NicolasPlata2004/ADANISS-2R/Videos_Youtube/02_Episodios/EP01/youtube/publicacion.md

# EP01 · Publicación en YouTube

## Título (elige uno, menos de 60 caracteres)

1. **¿Qué hay dentro de un cargador de celular?** (recomendado, va con la miniatura "¿QUÉ HAY DENTRO?")
2. Cómo 230 V se vuelven 5 V sin quemar tu celular
3. Tu cargador NO es solo un cable (y eso te protege)

## Miniatura

`final/EP01_miniatura.png` (1280×720). Mismo estilo Pizarra del video: "¿QUÉ HAY / DENTRO?", el cargador al centro, la marea roja que entra y la línea azul que sale.

## Descripción (copiar y pegar)

```
Son las 7:30, tu celular marca 4% y lo conectas sin pensar. Pero lo que sale del enchufe cambia de sentido unas 100 veces por segundo y empuja decenas de veces más fuerte de lo que tu batería aguanta. Entre los dos solo hay una cajita que cabe en tu mano. Seguimos la energía desde el enchufe hasta la batería: diodos, puente rectificador, condensador, conmutación, flyback, aislamiento galvánico, optoacoplador y USB Power Delivery.

00:00 Intro: 4% de batería
00:45 La analogía del agua
01:25 1. El sentido: diodos y puente rectificador
02:39 2. La presión: conmutación y flyback
04:31 3. El control: regulación y optoacoplador
05:07 4. Potencia y USB Power Delivery
05:59 5. El teléfono manda
06:18 Resumen

Glosario rápido
· Diodo: deja pasar la corriente en un solo sentido.
· Puente rectificador: 4 diodos que convierten la alterna en "colinas" de un solo sentido.
· Condensador de filtrado: se carga en las cimas y suelta energía en los valles.
· Flyback: guarda energía en el campo magnético del transformador y la suelta al otro lado.
· Aislamiento galvánico: entrada y salida sin conexión eléctrica directa.
· Optoacoplador: lleva la información de la salida a la entrada con luz.
· USB Power Delivery: el cargador ofrece un menú de tensiones (5, 9, 15, 20 V) y el teléfono elige.

#electronica #mecatronica #ingenieria
```

## Etiquetas

cargador de celular, cómo funciona un cargador, fuente conmutada, flyback, puente rectificador, diodo, condensador, corriente alterna, corriente continua, USB Power Delivery, carga rápida, aislamiento galvánico, optoacoplador, electrónica, mecatrónica, ingeniería

## Subtítulos

Sube `youtube/subtitulos.srt` en *Subtítulos > Español* (ya vienen corregidos: "alisarlo", "eléctrica", "4%", "USB-C").

## Pantalla final y tarjetas

- Los últimos 10 s del video (6:48–6:58) son la pantalla final: a la izquierda va el botón **Suscribirse** (sobre el logo) y a la derecha **dos videos** (los recuadros punteados).
- Tarjeta sugerida en 05:10 (cuando habla de carga rápida) hacia el próximo episodio.

## Notas de monetización (YPP)

- Narración propia, guion original y animaciones hechas para este video: es contenido original, no "reutilizado".
- Varía el formato visual entre episodios (Pizarra, Lámina técnica, Neón 3D) para no caer en "contenido repetitivo".
- Divulgación de contenido sintético: solo hace falta si muestras algo realista que pueda engañar (personas o hechos reales). Un video animado como este no la necesita.
