NicolasPlata2004/ADANISS-2R/(commit log)

2026-03-23 Se agrega los codigos de Matlab de Samuel y el mio, mas la carpeta de modelos
2026-05-18 Actualización del proyecto y adición de README
2026-05-18 Sincronizar con carpeta local: eliminar videos y animaciones, añadir códigos Arduino
2026-09-27 Documentar el proyecto completo y ordenar el repositorio
    - README nuevo (EN, con resumen FR/ES): trayectoria, identificación, control PID, resultados, electrónica y equipo.
    - Código final de firmware ESP32 y MATLAB (Codigos_Arduino/*, Codigos_Matlab/Codigo_final).
    - Caracterización de hombro y codo: firmware, datos CSV, scripts de ajuste e informes PDF.
    - Informe final (sin números de identificación) e imágenes en docs/img.
    - .gitignore para MATLAB/Simulink; se sacan del repo slprj/ y los .slxc generados.
2026-11-04 Añadir estudio de video para YouTube y el EP01 (cargador de celular)
    Kit para producir episodios del canal de curiosidades mecatrónicas
    sincronizados con la narración:
    - Motor de sincronía: transcripción palabra por palabra (faster-whisper),
    plan.yaml con escenas y marcas ancladas a frases de la narración,
    resolución a plan.json, subtítulos y capítulos para YouTube.
    - Formato Pizarra (Remotion/SVG), basado en los reels preferidos: 33
    escenas del EP01, subtítulos karaoke, rótulos, capítulos, pantalla final
    y miniatura.
    - Formato Lámina técnica (Manim + LaTeX) y formato Neón 3D (Three.js con
    bloom) como muestras sobre tramos reales del audio.
    - Masterización de audio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
2026-11-04 Añadir guía para crear escenas nuevas del formato Pizarra
    Claude-Session: https://claude.ai/code/session_011Hj3sVz1dZ1viMzTFfKPZh
2026-11-05 Serie Sensores: 10 guiones verificados, formato mixto taller y S01 provisional
    - Guiones S01-S10 (~10 min c/u) revisados dato por dato; VERIFICACION.md
    con las correcciones y las fuentes de los datos menos obvios.
    - guion_a_tiempos.py: tiempos estimados desde el guion cuando aun no hay voz.
    - Formato 'taller' (3D realista estilo reel del piezo + insertos 2D) y plan
    del S01; el resolvedor y el episodio aceptan planes sin audio.
    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
2026-11-05 Serie Sensores solo-3D: formato taller3d, escenas 3D del S01 al S03
    - Formato 'taller3d': todas las escenas son renders 3D. La version mixta
    del S01 se conserva como plan_mixto.yaml y composicion S01-Piezo-Mixto.
    - Escenas genericas 3D configurables desde plan.yaml: vitrina de objetos,
    linea de tiempo, lista numerada, agenda, codigo en portatil y cierre.
    - Librerias de objetos 3D (cotidianos, pantallas tactiles, PIR, Hall),
    osciloscopio y portatil con pantalla viva, texto 3D con las fuentes.
    - S01: escenas 3D que reemplazan a los insertos 2D (carga que se fuga,
    sonar, polarizacion, proteccion, huesos, baldosas de Tokio).
    - S02 y S03: escenas 3D completas y planes anclados al guion ve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
2026-11-05 Serie Sensores solo-3D: escenas y planes del S04 (Hall) y S05 (acelerometro)
    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
2026-11-05 Serie Sensores solo-3D: escenas y plan del S06 (giroscopio)
    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
2026-11-05 Serie Sensores solo-3D: escenas y plan del S07 (ultrasonido)
    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
2026-11-05 Serie Sensores solo-3D: escenas y plan del S08 (tiempo de vuelo y LiDAR)
    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
2026-11-05 S08: ajustes de cámara y textos
    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
2026-11-05 S09 Temperatura en versión solo-3D: escenas, objetos y plan
    Escenas nuevas (mesas a la misma temperatura vistas en térmico, agitación
    de partículas, bimetal y disco de hervidor con contactos, termistor/Pt100/
    termopar con valores reales, termopila y emisividad, DS18B20 con ESP32).
    El bimetal se curva hacia el acero (el latón queda en el lado convexo).
    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
2026-11-05 S10 Galga en versión solo-3D y mejoras comunes de texto
    Escenas nuevas del S10: báscula con rayos X y comparación con un cabello,
    cuatro patas que suman, hilo que se estira (R = ρ·L/A con Poisson 0,3),
    galga en zigzag con factor 2 y el ejemplo de 350 Ω, Ruge y el tanque,
    puente de Wheatstone con voltajes reales (2,5 mV con una galga, 10 mV con
    cuatro), celda de carga en S con deformación exagerada rotulada, HX711 +
    ESP32 con tara y calibración, límites y la serie completa al final.
    Comunes: el texto 3D se achica si no cabe en su placa, los títulos largos
    reducen su tamaño en vez de partirse, las vitrinas aceptan escala y número
    por objeto y simplifican las etiquetas en el plano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
2026-11-05 Serie Sensores: render con GPU y flujo de narración
    render_serie.bat renderiza los episodios 3D con la tarjeta gráfica.
    producir.bat ahora sirve para la serie: transcribe la voz real (la
    transcripción provisional del guion no cuenta), alinea el texto exacto
    del guion con los tiempos de Whisper para que los subtítulos no hereden
    errores, añade audio: al plan y nombra el video _3D_1080p.mp4.
    README con la estructura de la serie y los pasos.
    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
2026-11-05 S10: ala de avión de pasajeros y escalas en las vitrinas
    La semiala ahora tiene fuselaje, flecha, motor y winglet, centrada en su
    pedestal; con flexión 1 la punta sube un 25 % de la envergadura, como en
    el ensayo del 787. La grúa y el ala se achican en las vitrinas del S10.
    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
2026-11-05 Vitrinas sin pedestal vacío al empezar; S02: indio y etiqueta
    El primer objeto de cada vitrina aparece desde el comienzo (su etiqueta
    sigue esperando a la voz): antes había entre 2 y 8 s de pedestal vacío.
    S02: la vitrina del indio empieza por el óxido de indio y estaño, y la
    etiqueta «capacitancia» ya no se mete bajo el título.
    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
2026-11-05 Vitrinas: los objetos muy altos se achican en el plano cercano
    En el plano cercano cabe un objeto de ~4,3 de alto con su etiqueta encima;
    los más altos (cajero, cohete, termómetro, pinza…) se cortaban arriba o
    quedaban tapados por su etiqueta.
    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
2026-11-05 Vitrinas: más espacio para etiquetas con número o año
    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
2026-11-05 S05: inclinado o acelerando, la misma lectura
    La parte de los límites no mostraba nada durante ~26 s. Ahora dos
    acelerómetros de un eje (pesa entre resortes): uno inclinado 20° y quieto,
    otro horizontal acelerando a 0,34 g (= g·sen 20°); la pesa se corre igual y
    ambos marcan x: +0,34 g. Luego aparece el giroscopio.
    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
2026-11-05 S05/S06: brazos del huracán del hemisferio norte y globo legible
    Corrección científica: el huracán gira antihorario (hemisferio norte) pero
    sus brazos estaban curvados como uno del hemisferio sur; ahora se arrastran
    detrás del giro (hacia afuera curvan en sentido horario), igual que el
    flujo de entrada que muestran las flechas.
    El globo gira despacio para que el huracán (24° N) no se vaya detrás de la
    Tierra, y las placas del filtro y de la deriva ya no quedan bajo el título
    ni cortadas.
    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
2026-11-05 S07/S08: títulos que se encimaban, placas tapadas y encuadres
    S07: el cierre mostraba también los títulos del gancho; los «dos ojos» se
    ven de frente; las placas de 6,0 ms, del pulso ÷ 58 y de la temperatura ya
    no quedan bajo el título ni detrás de la pared.
    S08: la escena del ESP32 tenía títulos de marcas que se narran en la
    vitrina siguiente y se encimaban; la mano y la lectura en mm bajan para no
    quedar bajo el título; el dedo del gancho queda a media altura.
    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
2026-11-05 S09: la torre Eiffel en pantalla y sondas DS18B20 visibles
    Mientras la voz habla de la torre Eiffel ahora se ve la torre, que crece
    en verano (rotulado como exagerado: en la realidad hasta ~15 cm); la lámina
    bimetálica se calienta cuando la voz dice «si pegas dos láminas». Las
    sondas DS18B20 quedaban dentro de la protoboard: ahora están acostadas
    encima, con su cable, y el panel de lecturas ya no queda bajo el título.
    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
2026-11-05 S01: instrumentos en 3D y reloj de cuarzo visible desde el inicio
    Los osciloscopios y el voltímetro que todavía eran paneles 2D ahora son
    objetos 3D (Osciloscopio3D y un voltímetro de aguja nuevo), colocados con
    EnPantalla en el mismo punto de la pantalla y de frente a la cámara. Las
    marcas de orden y el punto de toque de la mesa también son 3D, y el panel
    32.768 = 2¹⁵ con las divisiones ÷2 es un panel 3D. El reloj de cuarzo ya
    se ve desde que empieza «Tres datos» (antes había 4,5 s vacíos).
    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
2026-11-05 S01: el piezo visible en las escenas del ESP32
    En la escena de protección el piezo y sus cables quedaban dentro de la
    protoboard y el osciloscopio salía cortado arriba; en el montaje el piezo
    se salía por la esquina. Ahora el piezo está sobre la protoboard / dentro
    del cuadro y el osciloscopio se ve desde el principio.
    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
2026-11-05 S02/S04/S10: salchicha visible, chip 49E y carteles sin encimarse
    S02: en «Corea del Sur» la salchicha no llegaba a verse (subía a los ~2 s);
    ahora se queda tocando la pantalla. La barra de touchRead es más baja y
    lleva sus etiquetas (touchRead, umbral) en vez de tapar el título.
    S04: corrección: el sensor lineal mostraba el rótulo «3144» aunque la voz
    y el título dicen 49E; ahora dice 49E y la barra de salida está rotulada
    (a 5 V, 2,5 V sin imán y sube con el campo). El cierre ya no deja el
    título encima del monitor.
    S10: el cartel del zigzag aparece cuando la galga ya está pegada (antes
    tapaba la galga flotante) y el plano final de la serie está más cerca.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
